flyingdoggoo/smart-home-security-system/(commit log)

2026-05-12 feat: Initial setup
    [partitions.csv]
2026-05-16 fix: espcam went wrong
    [code_camera_esp32.ino, esp32_io_node.ino]
2026-05-20 fix: esp32 cam
